fragosoamanda/inverted-pendulum/README.rst

Robô Pêndulo Invertido
######################

.. contents::
   :local:
   :depth: 2

Requisitos
**********
* O sistema deve estabilizar o robô pêndulo invertido na posição vertical;
* Deve realizar a leitura de sensores (giroscópio e acelerômetro) para estimar a inclinação.
Deve controlar os motores de forma a corrigir desvios e manter o equilíbrio.
Deve permitir ajuste dos parâmetros do controlador para testes.
Deve operar em tempo real, com resposta rápida e erro mínimo.
Deve respeitar os limites elétricos dos componentes (tensão, corrente e potência).

Visão geral
***********

Este projeto faz parte do Projeto Integrador III do curso de Engenharia Eletrônica do IFSC Florianópolis e tem como objetivo o desenvolvimento de um sistema de controle para um robô pêndulo invertido. O trabalho consiste em projetar e implementar um controlador capaz de estabilizar o sistema, mantendo-o em equilíbrio mesmo na presença de pequenas perturbações externas.

O desenvolvimento foi divido em quatro etapas:

- Etapa 1 (02/04/2026): Envolve a análise do sistema existente, incluindo identificação de componentes, testes de funcionamento e modelagem dos parâmetros necessários para o controle, com base em pesquisa.
- Etapa 2 (30/04/2026): Envolve o estudo de técnicas de controle, desenvolvimento da interface de testes, realização de testes em malha aberta e a análise do comportamento do sistema com base na identificação de seus parâmetros.
- Etapa 3 (28/05/2026): Envolve a definição do hardware de controle, desenvolvimento da placa controladora, projeto e refinamento do controlador, além da realização de testes em malha fechada.
- Etapa 4 (09/07/2026): Envolve a fabricação da PCB, o ajuste  do software, a integração do hardware de controle ao robô e a realização de testes  para validar o desempenho do sistema.

Equipe
======
- Amanda Fragoso Franceschini
- João Felipe Camargo Klöppel
- Rafael Suzin Pires

Professores
===========

- Matheus Leitzke Pinto
- Renan Augusto Starke
