fragosoamanda/inverted-pendulum/etapa_1/Img/Modelagem/diagrama.png

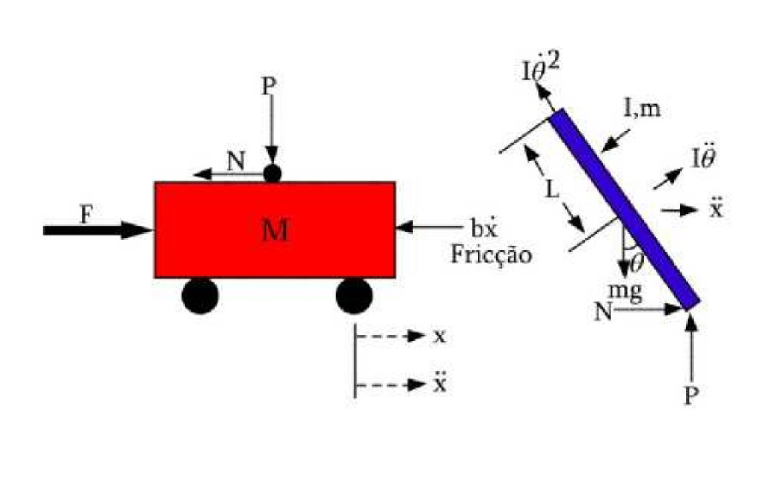
etapa_1/Img/Modelagem/diagrama.png
