fragosoamanda/inverted-pendulum/etapa_3/img/cont2.png

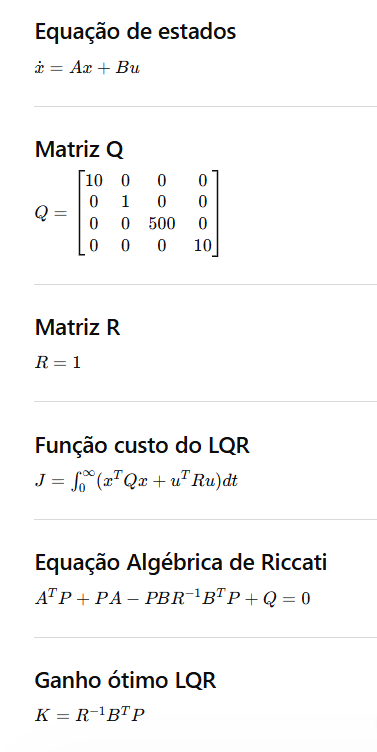
etapa_3/img/cont2.png
