fragosoamanda/inverted-pendulum/etapa_3/img/cont3.png

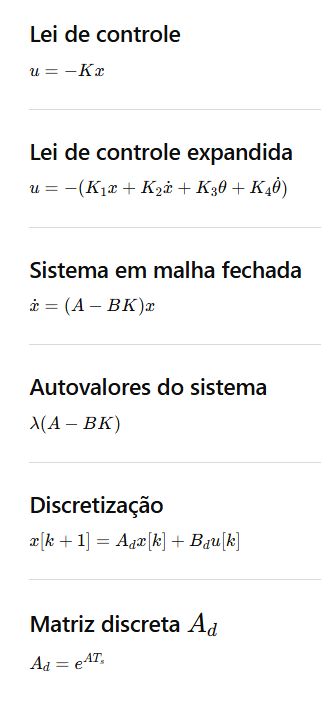
etapa_3/img/cont3.png
