fragosoamanda/inverted-pendulum/etapa_3/img/cont4.png

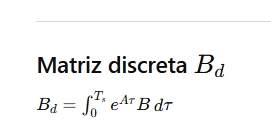
etapa_3/img/cont4.png
