fragosoamanda/inverted-pendulum/etapa_2/Dados_obtidos/Calibração.txt

ypr	-0.02	0.00	-0.03
ypr	-0.02	0.00	-0.03
ypr	-0.02	0.00	-0.03
ypr	-0.02	0.00	-0.03
ypr	-0.02	0.00	-0.03
ypr	-0.02	0.00	-0.03
ypr	-0.02	0.00	-0.03
ypr	-0.02	0.00	-0.03
ypr	-0.02	0.00	-0.03
ypr	-0.02	0.01	-0.03
ypr	-0.02	0.01	-0.03
ypr	-0.02	0.01	-0.03
ypr	-0.02	0.01	-0.03
ypr	-0.02	0.01	-0.03
ypr	-0.02	0.01	-0.04
ypr	-0.02	0.01	-0.04
ypr	-0.02	0.01	-0.04
ypr	-0.02	0.01	-0.04
ypr	-0.02	0.01	-0.04
ypr	-0.03	0.01	-0.05
ypr	-0.03	0.01	-0.05
ypr	-0.03	0.01	-0.05
ypr	-0.03	0.01	-0.05
ypr	-0.03	0.01	-0.05
ypr	-0.03	0.01	-0.05
ypr	-0.03	0.01	-0.05
ypr	-0.03	0.01	-0.05
ypr	-0.03	0.01	-0.05
ypr	-0.03	0.01	-0.05
ypr	-0.03	0.01	-0.05
ypr	-0.03	0.01	-0.05
ypr	-0.04	0.01	-0.05
ypr	-0.04	0.01	-0.05
ypr	-0.04	0.01	-0.05
ypr	-0.04	0.01	-0.05
ypr	-0.04	0.01	-0.05
ypr	-0.04	0.01	-0.05
ypr	-0.04	0.01	-0.05
ypr	-0.04	0.01	-0.05
ypr	-0.04	0.01	-0.05
ypr	-0.04	0.01	-0.05
ypr	-0.04	0.01	-0.05
ypr	-0.04	0.01	-0.05
ypr	-0.04	0.01	-0.05
ypr	-0.05	0.01	-0.05
ypr	-0.05	0.01	-0.05
ypr	-0.05	0.01	-0.05
ypr	-0.05	0.01	-0.05
ypr	-0.05	0.01	-0.05
ypr	-0.05	0.01	-0.05
ypr	-0.05	0.01	-0.05
ypr	-0.05	0.01	-0.05
ypr	-0.05	0.01	-0.05
ypr	-0.05	0.01	-0.05
ypr	-0.05	0.01	-0.05
ypr	-0.05	0.01	-0.06
ypr	-0.05	0.01	-0.06
ypr	-0.05	0.01	-0.06
ypr	-0.05	0.01	-0.06
ypr	-0.05	0.01	-0.06
ypr	-0.05	0.01	-0.06
ypr	-0.05	0.01	-0.06
ypr	-0.06	0.01	-0.06
ypr	-0.06	0.01	-0.06
ypr	-0.06	0.01	-0.06
ypr	-0.06	0.01	-0.06
ypr	-0.06	0.01	-0.06
ypr	-0.06	0.01	-0.06
ypr	-0.06	0.01	-0.06
ypr	-0.06	0.01	-0.06
ypr	-0.06	0.01	-0.06
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
ypr	-0.02	-9.55	-0.55
ypr	-0.02	-9.47	-0.55
ypr	-0.03	-9.40	-0.56
ypr	-0.03	-9.32	-0.56
ypr	-0.02	-9.24	-0.56
ypr	-0.02	-9.16	-0.57
ypr	-0.02	-9.08	-0.57
ypr	-0.02	-9.00	-0.57
ypr	-0.02	-8.93	-0.57
ypr	-0.02	-8.86	-0.58
ypr	-0.02	-8.78	-0.58
ypr	-0.01	-8.71	-0.58
ypr	-0.01	-8.64	-0.59
ypr	-0.00	-8.58	-0.59
ypr	-0.00	-8.50	-0.59
ypr	-0.00	-8.44	-0.59
ypr	0.00	-8.38	-0.59
ypr	0.00	-8.32	-0.59
ypr	0.01	-8.26	-0.59
ypr	0.02	-8.21	-0.59
ypr	0.02	-8.16	-0.59
