fragosoamanda/inverted-pendulum/(list of files, drawings)

Other design files:
etapa_4/Codigo/inverted_pendulum-certo/M4.pdsprj
etapa_4/Codigo/inverted_pendulum-certo/Project Backups/M4 [20260423, 09-23-06].pdsprj
etapa_4/Codigo/inverted_pendulum-certo/Project Backups/M4 [20260427, 04-35-41].pdsprj
etapa_4/Codigo/inverted_pendulum-certo/Project Backups/M4 [20260427, 05-08-31].pdsprj
etapa_4/Codigo/inverted_pendulum-certo/Project Backups/M4 [20260427, 07-15-48].pdsprj
etapa_4/Codigo/inverted_pendulum-certo/Project Backups/M4 [20260427, 07-19-04].pdsprj
etapa_4/Codigo/inverted_pendulum-certo/Project Backups/M4 [20260427, 08-30-21].pdsprj
etapa_4/Codigo/inverted_pendulum-certo/Project Backups/M4 [20260428, 04-12-21].pdsprj
etapa_4/Codigo/inverted_pendulum-certo/Project Backups/M4 [20260428, 10-53-42].pdsprj
