fragosoamanda/inverted-pendulum/(commit log)

2026-05-28 adicionado os códigos
    [M4 [20260423, 09-23-06].pdsprj, M4 [20260427, 04-35-41].pdsprj, M4 [20260427, 05-08-31].pdsprj, M4 [20260427, 07-15-48].pdsprj, M4 [20260427, 07-19-04].pdsprj, M4 [20260427, 08-30-21].pdsprj, M4 [20260428, 04-12-21].pdsprj, M4 [20260428, 10-53-42].pdsprj]
2026-06-26 Revise stage 4 overview in README
    Updated the description of stage 4 to clarify its focus on PCB fabrication, software integration, and stability testing.
2026-06-30 código adicionado
    [M4 [20260423, 09-23-06].pdsprj, M4 [20260427, 04-35-41].pdsprj, M4 [20260427, 05-08-31].pdsprj, M4 [20260427, 07-15-48].pdsprj, M4 [20260427, 07-19-04].pdsprj, M4 [20260427, 08-30-21].pdsprj, M4 [20260428, 04-12-21].pdsprj, M4 [20260428, 10-53-42].pdsprj]
2026-07-08 controle do RPM do motor e refatoração do código
